Dmytry/Pythagoras/(list of files, cad)

Other CAD files:
mechanics/pythagoras/grille_cylinder.scad
mechanics/pythagoras/linear_rod2.scad
