Dmytry/Pythagoras/(commit log)

2023-01-22 Updated for new hardware
    [pythagoras-bigtreetech-octopus.cfg]
2023-01-24 More config changes
    [pythagoras-bigtreetech-octopus.cfg]
2023-02-25 Initial commit of Pythagoras and Marionette parts
    [bamboo_arm.scad, bamboo_panel.scad, bamboo_rod_tip.scad, belt_joiner.scad, belt_zip.scad, common.scad, corners.scad, cutting_jig.scad]
2023-02-25 Fixed includes
    [corners.scad, dimensions.scad, proof_of_concept.scad, stickbot.scad, stickbot_balanced.scad]
2023-02-25 Improved .stl generation script
    [corners.scad]
2023-02-26 More Marionette work, close to motorized test
    [corners.scad]
2023-02-26 Config for Marionette
    [marionette-bigtreetech-octopus.cfg]
2023-03-03 Prototype air bearing, prototype z mechanism (incomplete)
    [air_bearing.scad, corners.scad, dimensions.scad, z_poc.scad]
2023-03-10 Refactor, cleanup
    [marionette-bigtreetech-octopus.cfg, z_poc.scad]
2023-03-11 Started work on 2020 rail based prototype
2023-03-19 Depth probe, cutting jig, and a bunch of other changes
2023-03-20 Depth probe improvements
2023-03-24 Updated build123d submodule, minor improvements, non working kinematic probe.
2023-03-27 WIP Z motor mount, fixed link in readme, WIP carriage for marionette, drilling jigs for carriage.
2023-04-01 Kinematic probe improvements, motor mount.
    [marionette-bigtreetech-octopus.cfg]
2023-04-15 Marionette improvements, guitar tuners for tensioning, a tool for making a bent nozzle, etc.
    [dimensions.scad, marionette-bigtreetech-octopus.cfg, stickbot_balanced.scad]
2023-04-22 Some helper scripts
    [marionette-bigtreetech-octopus.cfg]
